snilard/Li-pol-nabijecka/nabijecka-schema.pdf

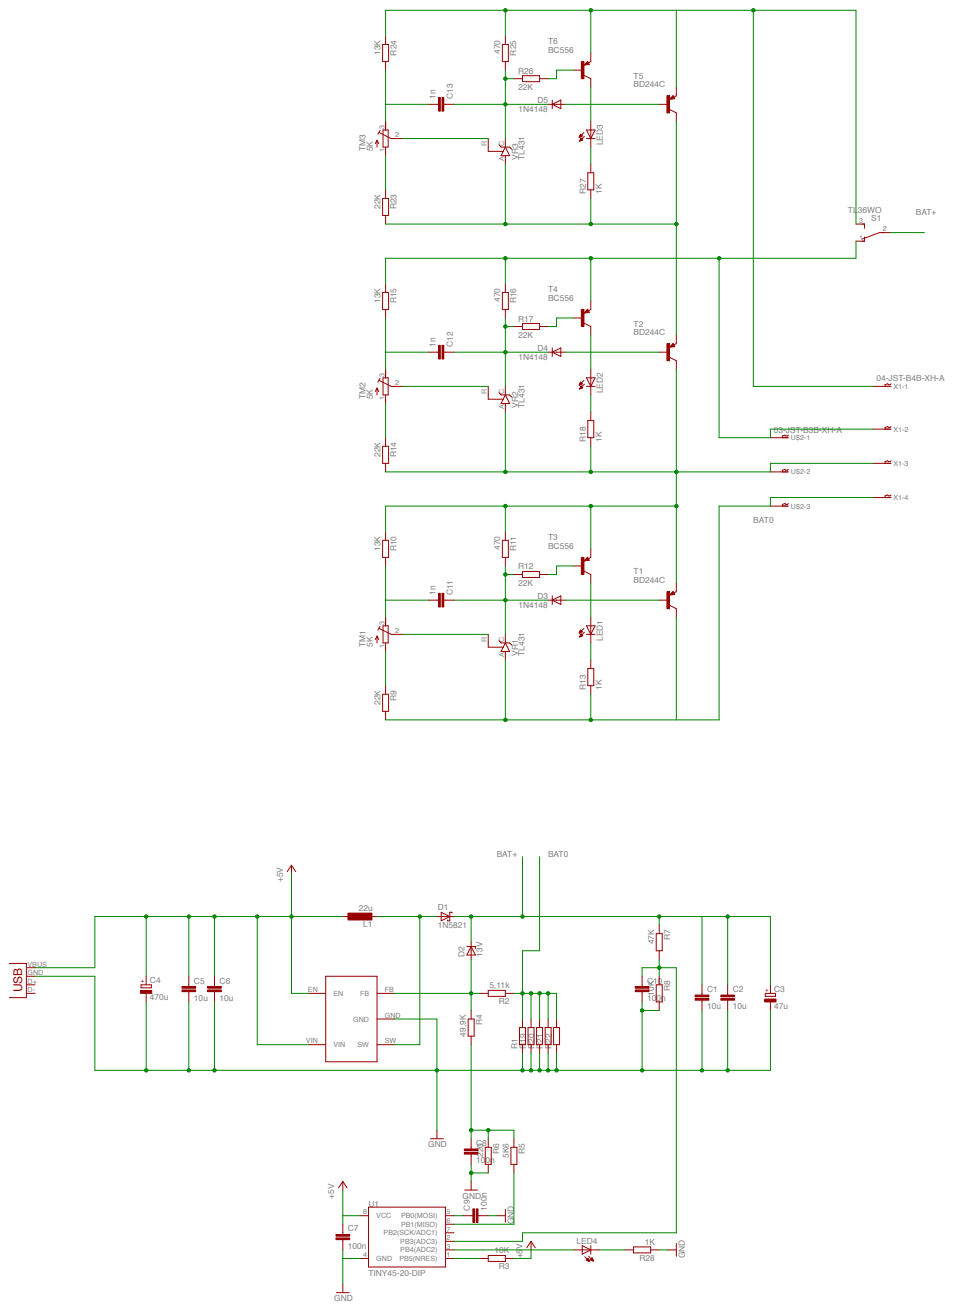
[picture p1: page 1]
