snilard/Li-pol-nabijecka/nabijecka-PCB.pdf

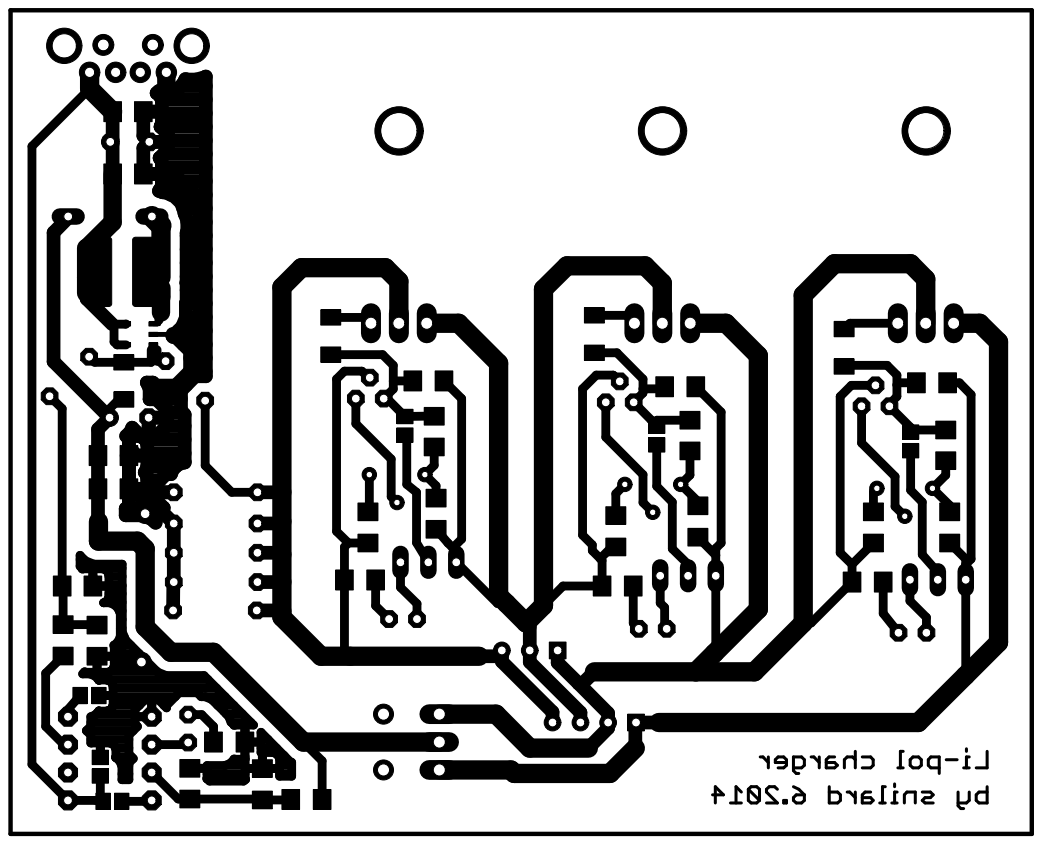
[picture p2: page 1]
