snilard/Li-pol-nabijecka/nabijecka.brd

## EAGLE design nabijecka.brd (2014-07-02)

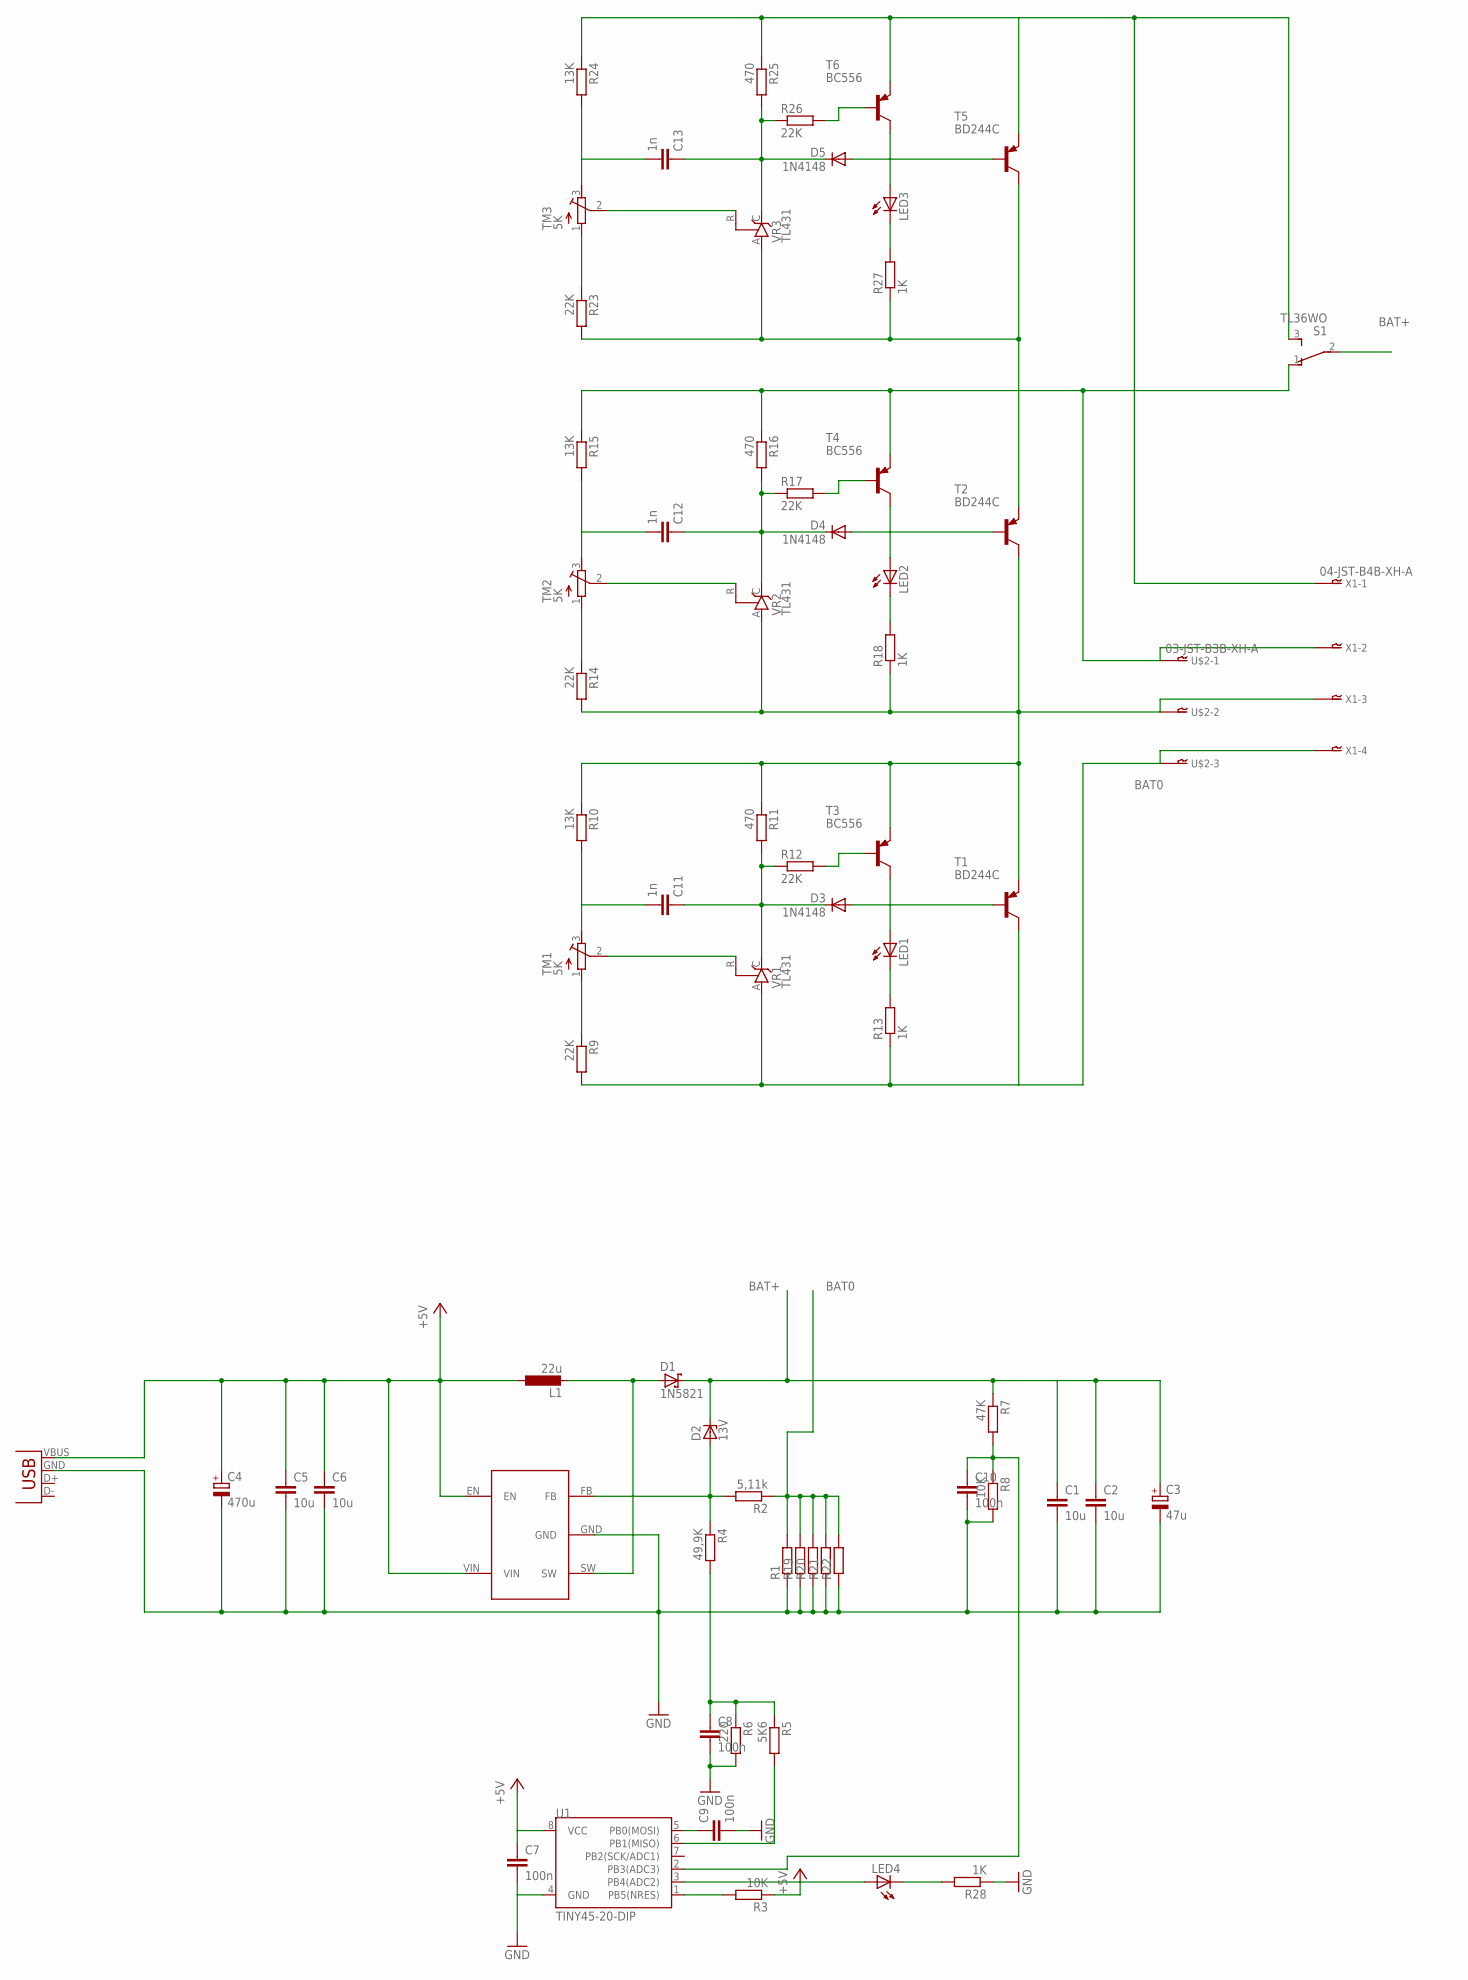
[picture p3: schematic nabijecka.sch]

Parts:
C1, C2, C5, C6: 10u; C1206
C3: 47u; E3,5-8
C4: 470u; E3,5-8
C7, C9: 100n; C0805
C8, C10: 100n; C1206
C11, C12, C13: 1n; C1206
D1: 1N5821; DO35-7
D2: 13V; SOD80C
D3, D4, D5: 1N4148; SOD80C
JP2: USB-A-H
L1: 22u; POWER-CHOKE_WE-TPC
LED1, LED2, LED3, LED4: LED3MM
R1, R19, R20, R21, R22: R-EU_0204/7; 0204/7
R2: 5,11k; 0204/5
R3: 10K; R0805
R4: 49,9K; 0204/5
R5: 5K6; R1206
R6: 220; R1206
R7: 47K; R1206
R8: 10K; R1206
R9, R14, R23: 22K; R1206
R10, R15, R24: 13K; R1206
R11, R16, R25: 470; R1206
R12, R17, R26: 22K; R0805
R13, R18, R27, R28: 1K; R1206
S1: TL36WO; TL3XWO
T1, T2, T5: BD244C; TO220
T3, T4, T6: BC556; TO92-EBC
TM1, TM2, TM3: 5K; RTRIM64P
U1: TINY45-20-DIP; DIP08
U$1: MIC2287
U$2: 03-JST-B3B-XH-A; B3B-XH
VR1, VR2, VR3: TL431; TO92-CLP
X1: 04-JST-B4B-XH-A; B4B-XH

Connections:
+5V: C4.+, C5.1, C6.1, C7.1, JP2.VBUS (GND), L1.1, R3.1, U1.8 (VCC), U$1.EN, U$1.VIN
BAT0: R1.2, R2.1, R9.2, R13.1, R19.2, R20.2, R21.2, R22.2, T1.2 (C), U$2.P$3, VR1.A, X1.P$4
BAT1: R10.1, R11.1, R14.2, R18.1, T1.3 (E), T2.2 (C), T3.E, U$2.P$2, VR2.A, X1.P$3
BAT2: R15.1, R16.1, R23.2, R27.1, S1.1 (O), T2.3 (E), T4.E, T5.2 (C), U$2.P$1, VR3.A, X1.P$2
BAT+: C1.1, C2.1, C3.+, D1.C, D2.C, R7.1, S1.2
GND: C1.2, C2.2, C3.-, C4.-, C5.2, C6.2, C7.2, C8.2, C9.2, C10.2, JP2.GND (VBUS), R1.1, R6.2, R8.2, R19.1, R20.1, R21.1, R22.1, R28.1, U1.4 (GND), U$1.GND
unnamed: C8.1, R4.2, R5.1, R6.1
unnamed: D1.A, L1.2, U$1.SW
unnamed: D2.A, R2.2, R4.1, U$1.FB
unnamed: R3.2, U1.1 (PB5(NRES))
unnamed: D3.A, T1.1 (B)
unnamed: R5.2, U1.6 (PB1(MISO))
unnamed: D4.A, T2.1 (B)
unnamed: C9.1, U1.5 (PB0(MOSI))
unnamed: C11.1, D3.C, R11.2, R12.1, VR1.C
unnamed: C10.1, R7.2, R8.1, U1.2 (PB3(ADC3))
unnamed: D5.A, T5.1 (B)
unnamed: C12.1, D4.C, R16.2, R17.1, VR2.C
unnamed: C11.2, R10.2, TM1.3 (A)
unnamed: TM1.2 (S), VR1.R
unnamed: R9.1, TM1.1 (E)
unnamed: LED1.K (C), R13.2
unnamed: C12.2, R15.2, TM2.3 (A)
unnamed: LED1.A, T3.C
unnamed: TM2.2 (S), VR2.R
unnamed: R12.2, T3.B
unnamed: C13.1, D5.C, R25.2, R26.1, VR3.C
unnamed: R14.1, TM2.1 (E)
unnamed: R17.2, T4.B
unnamed: LED2.K (C), R18.2
unnamed: LED2.A, T4.C
unnamed: C13.2, R24.2, TM3.3 (A)
unnamed: TM3.2 (S), VR3.R
unnamed: R23.1, TM3.1 (E)
unnamed: R26.2, T6.B
unnamed: LED3.K (C), R27.2
unnamed: LED3.A, T6.C
unnamed: R24.1, R25.1, S1.3 (S), T5.3 (E), T6.E, X1.P$1
unnamed: LED4.K (C), R28.2
unnamed: LED4.A, U1.3 (PB4(ADC2))

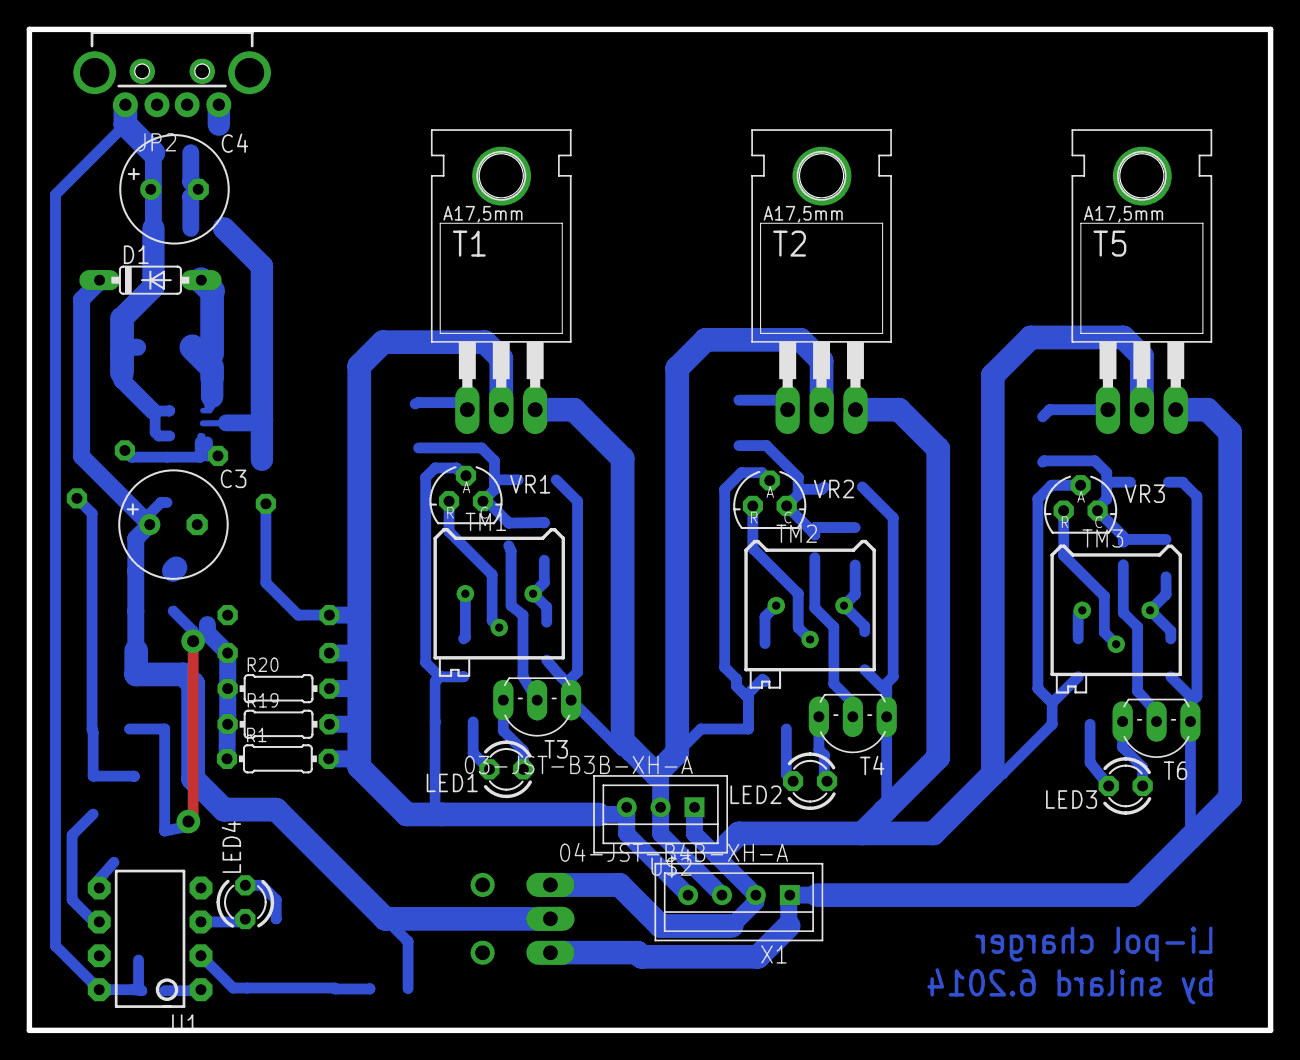
[picture p4: board nabijecka.brd from above]

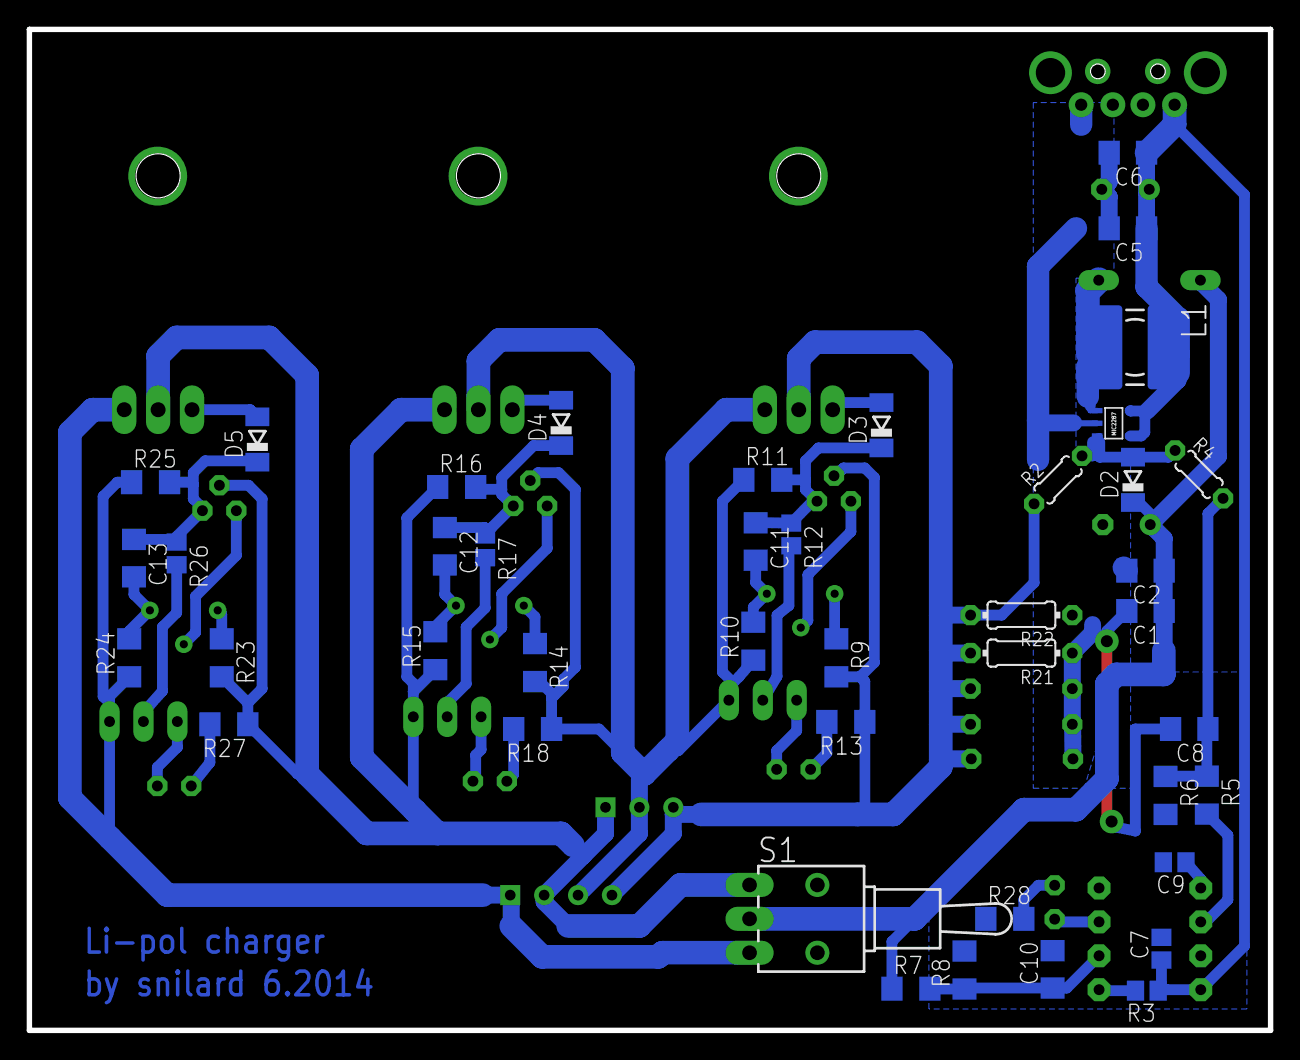
[picture p5: board nabijecka.brd from below]

Board: 2 copper layers, 93.0 x 75.0 mm, 69 parts (43 on the bottom side), 40 nets.
