snilard/Li-pol-nabijecka/(commit log)

2014-06-21 Add first working code.
    Voltage on PB3 is measured periodically. LED is turned on if voltage exceed treshold. This will serve as indicator of charged battery. Every cycle PWM is decreaded if voltage is lower than treshold and increaed if voltage id above treshold. This will serve for lowering current when target voltage is achieved.
2014-06-21 Add final circuit schematics and PCB layout.
    [nabijecka1.brd, nabijecka1.sch]
2014-06-21 Add PCB template in PDF.
2014-07-02 Add 2S/3S battery recognition. Set voltages for 4,13 V per cell.
2014-07-02 Add schema in PDF. Rename files.
    [nabijecka.brd, nabijecka.sch]
2014-11-16 Add periodic blinking. Change of charged indicator to current treshold.
2014-11-16 Changed target voltage to 4,17 V per cell.
